BenKohn2004/Mask_Lights/Lights_Snapshot_1.png

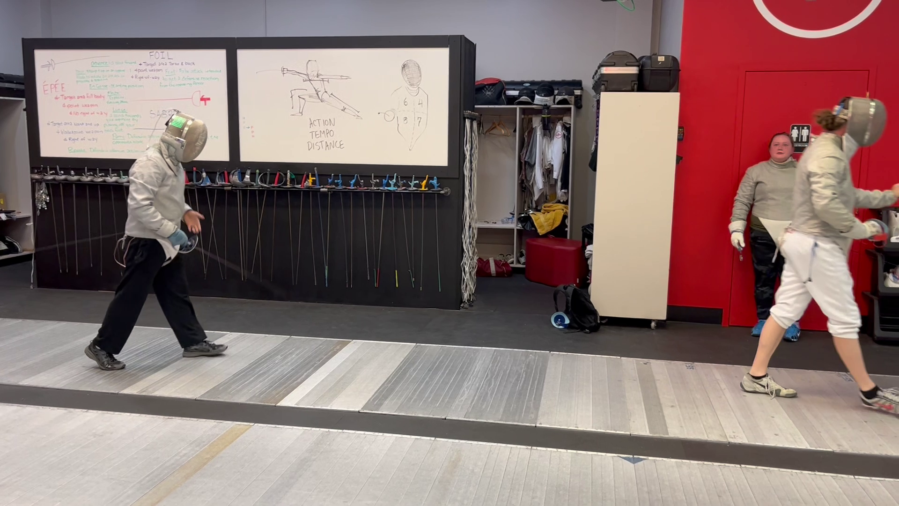
Lights_Snapshot_1.png
