BenKohn2004/Mask_Lights/Mask_Green_Light.jpg

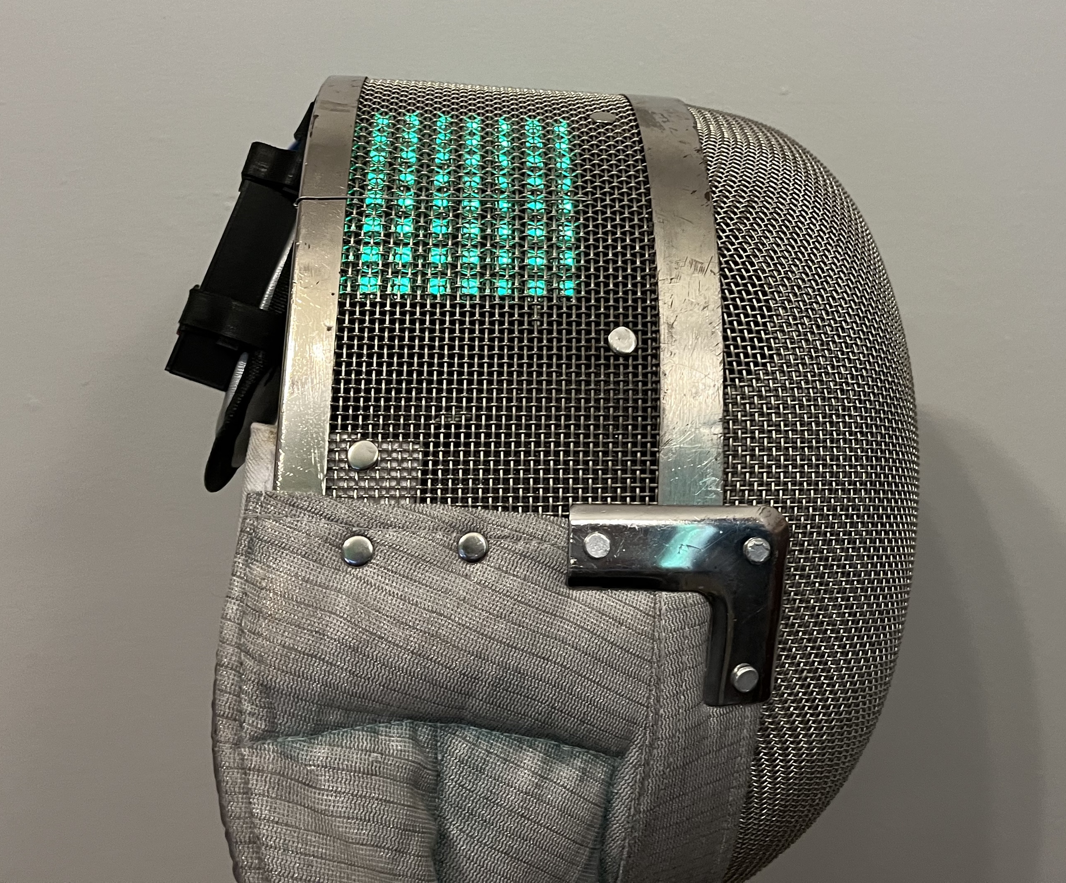
Mask_Green_Light.jpg
