BenKohn2004/Mask_Lights/Mask_Interior.jpg

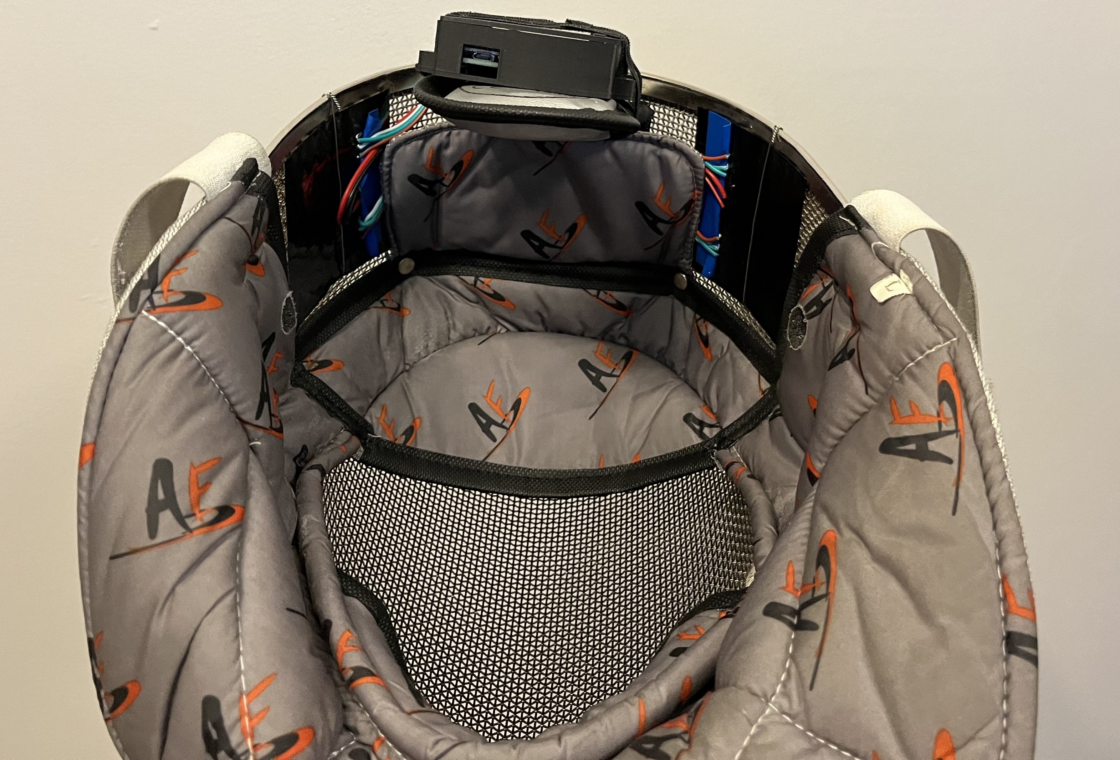
Mask_Interior.jpg
