BenKohn2004/Mask_Lights/Mask_Lights_PCB_Attached.jpg

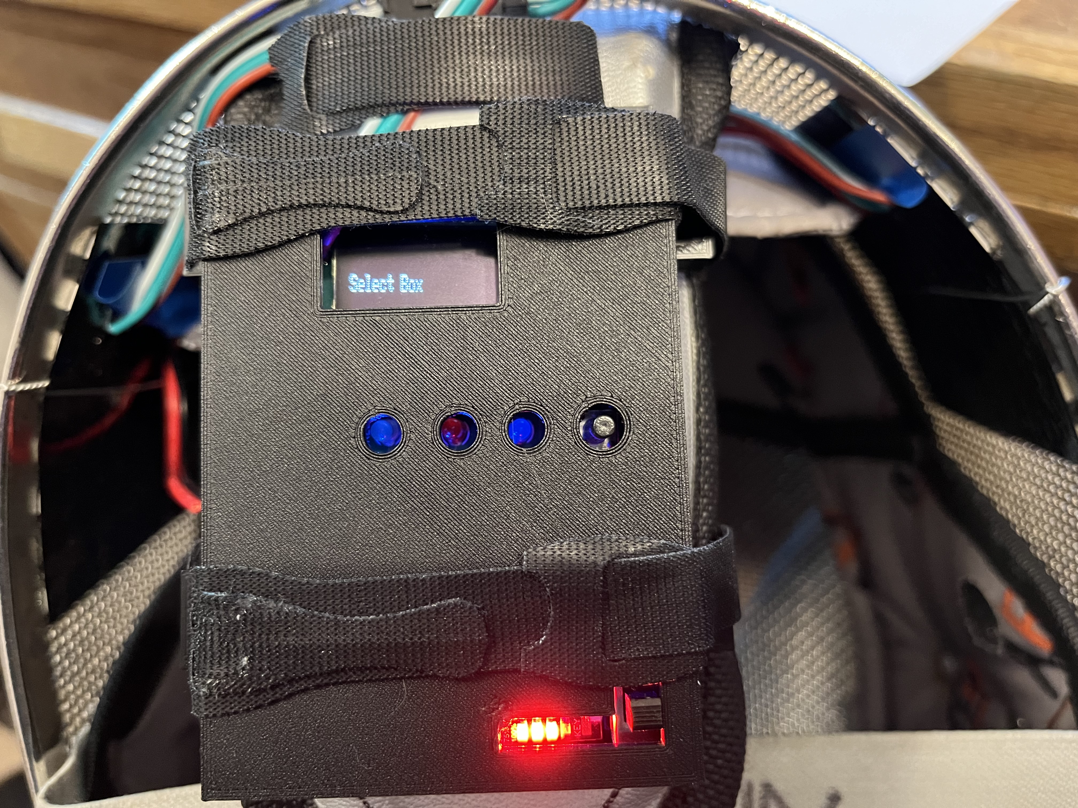
Mask_Lights_PCB_Attached.jpg
