BenKohn2004/Mask_Lights/Mask_Lights_PCB_Holder.png

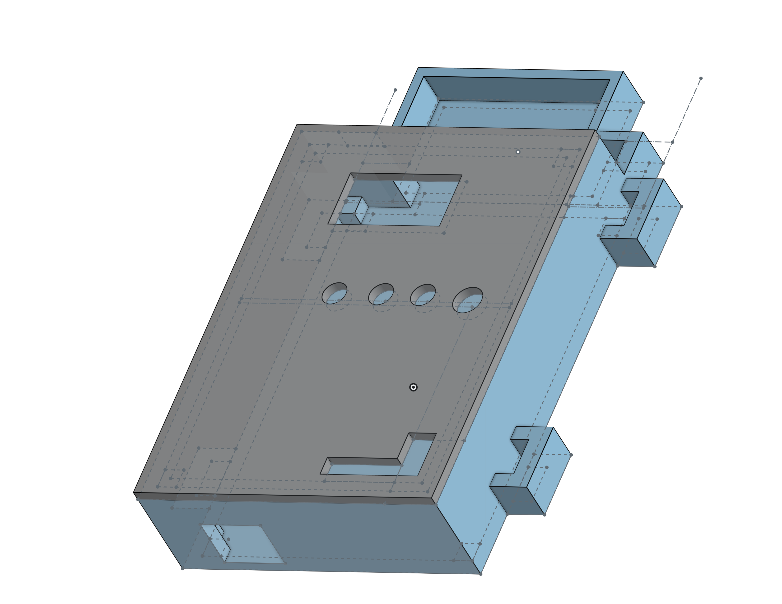
Mask_Lights_PCB_Holder.png
