BenKohn2004/Mask_Lights/PCB_Bottom.PNG

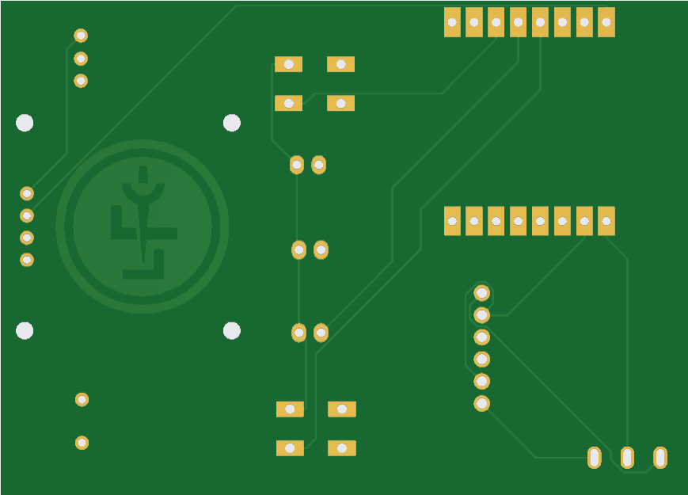
PCB_Bottom.PNG
