BenKohn2004/Mask_Lights/Schematic_Favero-Light-Relays.pdf

# Favero Serial Parser LED Relay Control

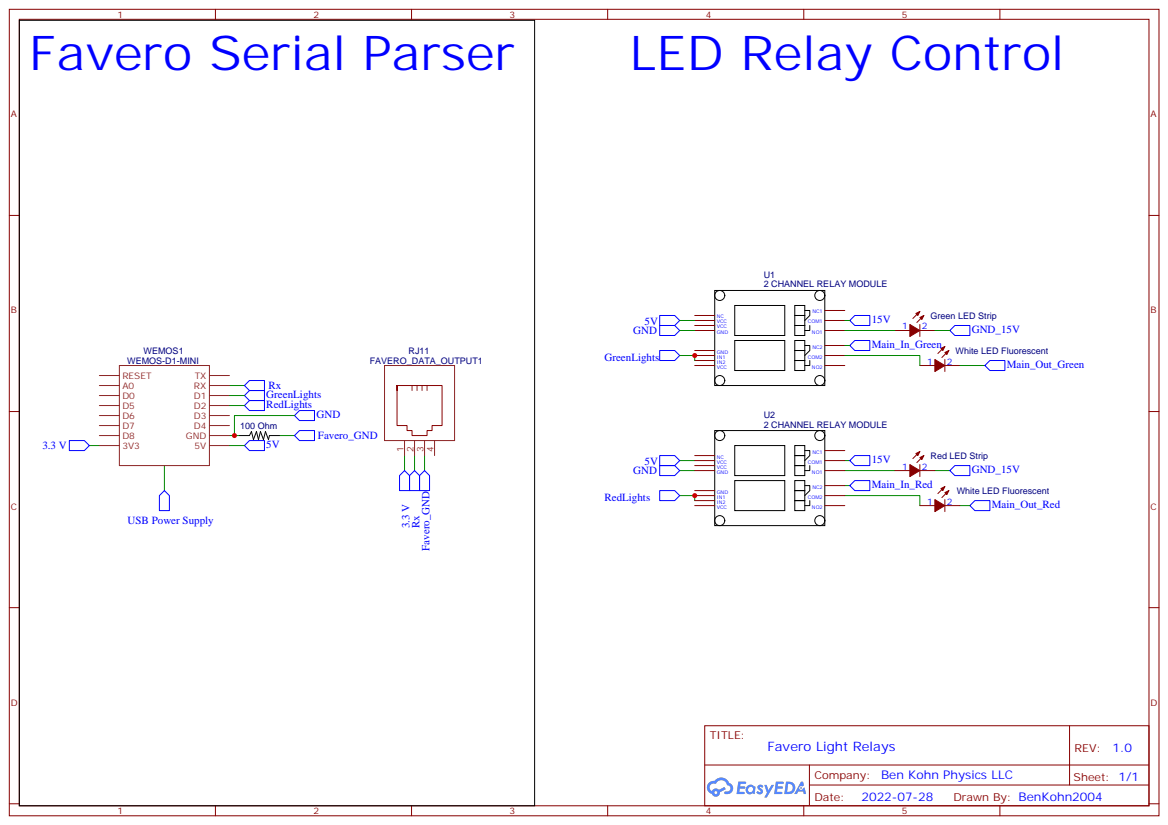
[picture p11: page 1]

Company: Ben Kohn Physics LLC
