BenKohn2004/Mask_Lights/Schematic_Mask_Lights_PCB.pdf

# Mask Light and Battery

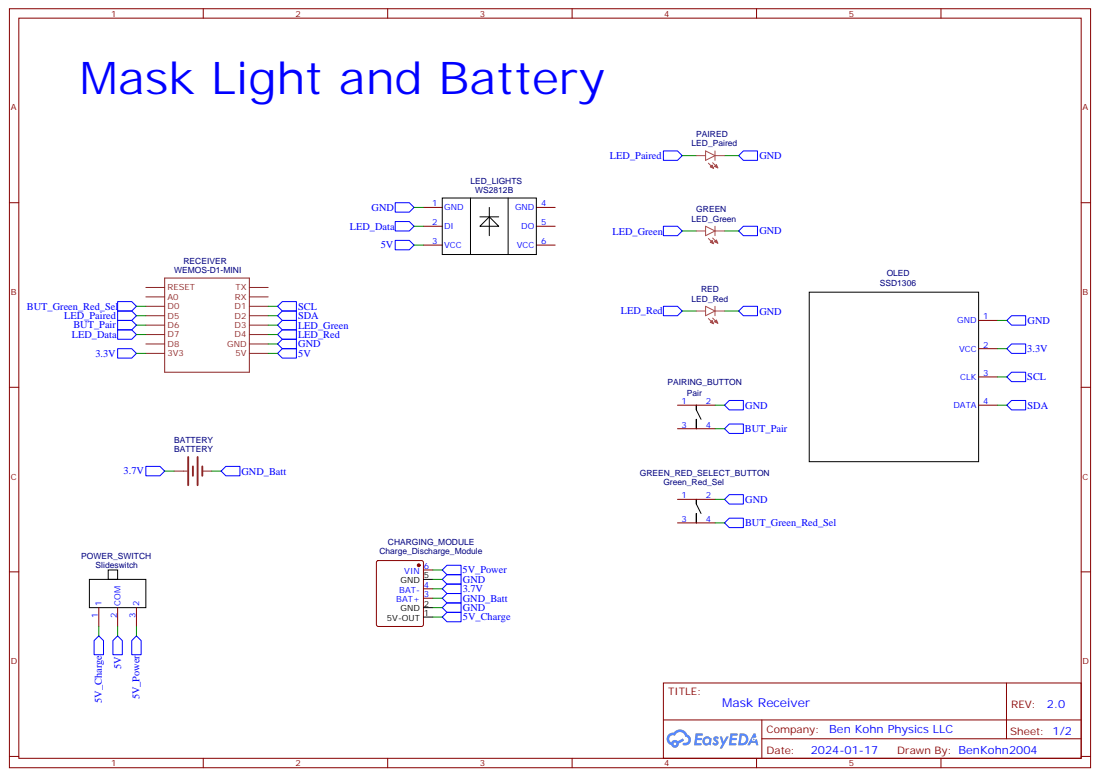
[picture p12: page 1]

Company: Ben Kohn Physics LLC
