BenKohn2004/Mask_Lights/8266_Parser_and_Transmitter/8266_Parser_and_Transmitter.ino

#include <ESP8266WiFi.h>
#include <espnow.h>

#define BoxName "Favero_One"

#define Test_Mode false

// REPLACE WITH RECEIVER MAC Address
uint8_t broadcastAddress[] = { 0xFF, 0xFF, 0xFF, 0xFF, 0xFF, 0xFF };

// For Reading Favero Serial
const unsigned int MAX_MESSAGE_LENGTH = 10;
const unsigned int MAX_SERIAL_BUFFER_BYTES = 512;
const char STARTING_BYTE = 255;

// Lights for the Relay Outputs
const int RedLights = 4;           // D2
const int GreenLights = 5;         // D1
const int White_RedLights = 14;    // D5
const int White_GreenLights = 12;  // D6

// Shows if new data is available for display
bool new_data = false;

// Initializes Message_Position
unsigned int message_pos = 0;

unsigned long lastTransmitTime = 0;
unsigned long transmitInterval = 3000;  // send readings timer

// ESPNow communication packet
typedef struct struct_message {
  uint8_t msgType;     // Transmitter, Receiver
  uint8_t macAddr[6];  // The MAC address of the message sender
  int unsigned Right_Score;
  int unsigned Left_Score;
  int unsigned Seconds_Remaining;
  int unsigned Minutes_Remaining;
  bool Green_Light;
  bool Red_Light;
  bool White_Green_Light;
  bool White_Red_Light;
  bool Yellow_Green_Light;
  bool Yellow_Red_Light;
  bool Yellow_Card_Green;
  bool Yellow_Card_Red;
  bool Red_Card_Green;
  bool Red_Card_Red;
  bool Priority_Left;
  bool Priority_Right;
  char customMessage[32];  // Array to hold a fixed-length string of 31 characters + null terminator, This is the name of the sender
} struct_message;

// Create a struct_message called myData
struct_message myData;

// Callback when data is sent
void OnDataSent(uint8_t *mac_addr, uint8_t sendStatus) {
  Serial.print(BoxName);
  Serial.print(": Last Packet Send Status: ");
  if (sendStatus == 0) {
    Serial.println("Delivery success");
  } else {
    Serial.println("Delivery fail");
  }
}

void parseMacAddress(const String &macAddressStr, uint8_t macAddr[6]) {
  char macChars[18];
  macAddressStr.toCharArray(macChars, sizeof(macChars));
  sscanf(macChars, "%hhx:%hhx:%hhx:%hhx:%hhx:%hhx",
         &macAddr[0], &macAddr[1], &macAddr[2],
         &macAddr[3], &macAddr[4], &macAddr[5]);
}

void setup() {
  // Init Serial Monitor
  Serial.begin(2400);

  // Set device as a Wi-Fi Station
  WiFi.mode(WIFI_STA);
  Serial.println(WiFi.macAddress());

  // Get MAC address as a string
  String macAddressStr = WiFi.macAddress();

  // Parse MAC address string and store it in myData.macAddr
  parseMacAddress(macAddressStr, myData.macAddr);

  // Use strcpy to copy the string "Favero_One" into the customMessage array
  strcpy(myData.customMessage, BoxName);

  // Init ESP-NOW
  if (esp_now_init() != 0) {
    Serial.println("Error initializing ESP-NOW");
    return;

    // Sets Arduino Pins to Output Mode
    pinMode(RedLights, OUTPUT);
    pinMode(GreenLights, OUTPUT);
    pinMode(White_RedLights, OUTPUT);
    pinMode(White_GreenLights, OUTPUT);
  }

  // Once ESPNow is successfully Init, we will register for Send CB to
  // get the status of Trasnmitted packet
  esp_now_set_self_role(ESP_NOW_ROLE_CONTROLLER);
  esp_now_register_send_cb(OnDataSent);

  // Register peer
  esp_now_add_peer(broadcastAddress, ESP_NOW_ROLE_SLAVE, 1, NULL, 0);
}

void loop() {
  if (Test_Mode) {                                         // Allows for testing the receiver functionality
    if (millis() - lastTransmitTime > transmitInterval) {  // by alternating Green and Red Lights
      if (myData.Green_Light) {
        myData.Green_Light = 0;
        myData.Red_Light = 1;
      } else {
        myData.Green_Light = 1;
        myData.Red_Light = 0;
      }
    }
  } else {
    Favero_Parser();  // Calls the Function to Parse the Favero Data
  }

  if ((new_data == true) || (millis() - lastTransmitTime > transmitInterval)) {
    lastTransmitTime = millis();
    // Send message via ESP-NOW
    esp_now_send(broadcastAddress, (uint8_t *)&myData, sizeof(myData));
    new_data = false;
  }
}
