BenKohn2004/Mask_Lights/8266_Parser_and_Transmitter/hex_string_to_int.ino

unsigned int hex_string_to_int(char msg)
{
// Uses else if statements to convert a Hex value, viewed as a string to an integer for 0 to 99
  unsigned int converted_int;
  if (msg == 0) {converted_int = 0;}
  else if (msg == 1) {converted_int = 1;}
  else if (msg == 2) {converted_int = 2;}
  else if (msg == 3) {converted_int = 3;}
  else if (msg == 4) {converted_int = 4;}
  else if (msg == 5) {converted_int = 5;}
  else if (msg == 6) {converted_int = 6;}
  else if (msg == 7) {converted_int = 7;}
  else if (msg == 8) {converted_int = 8;}
  else if (msg == 9) {converted_int = 9;}
  else if (msg == 16) {converted_int = 10;}
  else if (msg == 17) {converted_int = 11;}
  else if (msg == 18) {converted_int = 12;}
  else if (msg == 19) {converted_int = 13;}
  else if (msg == 20) {converted_int = 14;}
  else if (msg == 21) {converted_int = 15;}
  else if (msg == 22) {converted_int = 16;}
  else if (msg == 23) {converted_int = 17;}
  else if (msg == 24) {converted_int = 18;}
  else if (msg == 25) {converted_int = 19;}
  else if (msg == 32) {converted_int = 20;}
  else if (msg == 33) {converted_int = 21;}
  else if (msg == 34) {converted_int = 22;}
  else if (msg == 35) {converted_int = 23;}
  else if (msg == 36) {converted_int = 24;}
  else if (msg == 37) {converted_int = 25;}
  else if (msg == 38) {converted_int = 26;}
  else if (msg == 39) {converted_int = 27;}
  else if (msg == 40) {converted_int = 28;}
  else if (msg == 41) {converted_int = 29;}
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
  else if (msg == 149) {converted_int = 95;}
  else if (msg == 150) {converted_int = 96;}
  else if (msg == 151) {converted_int = 97;}
  else if (msg == 152) {converted_int = 98;}
  else if (msg == 153) {converted_int = 99;}
  else {converted_int = 0;}

  return converted_int;
}
